perivarf/OpenRadioBuoy/hardware/buoy_PCB/OLB.kicad_pcb

## KiCad design hardware/buoy_PCB/OLB.kicad_pcb (2026-11-14)

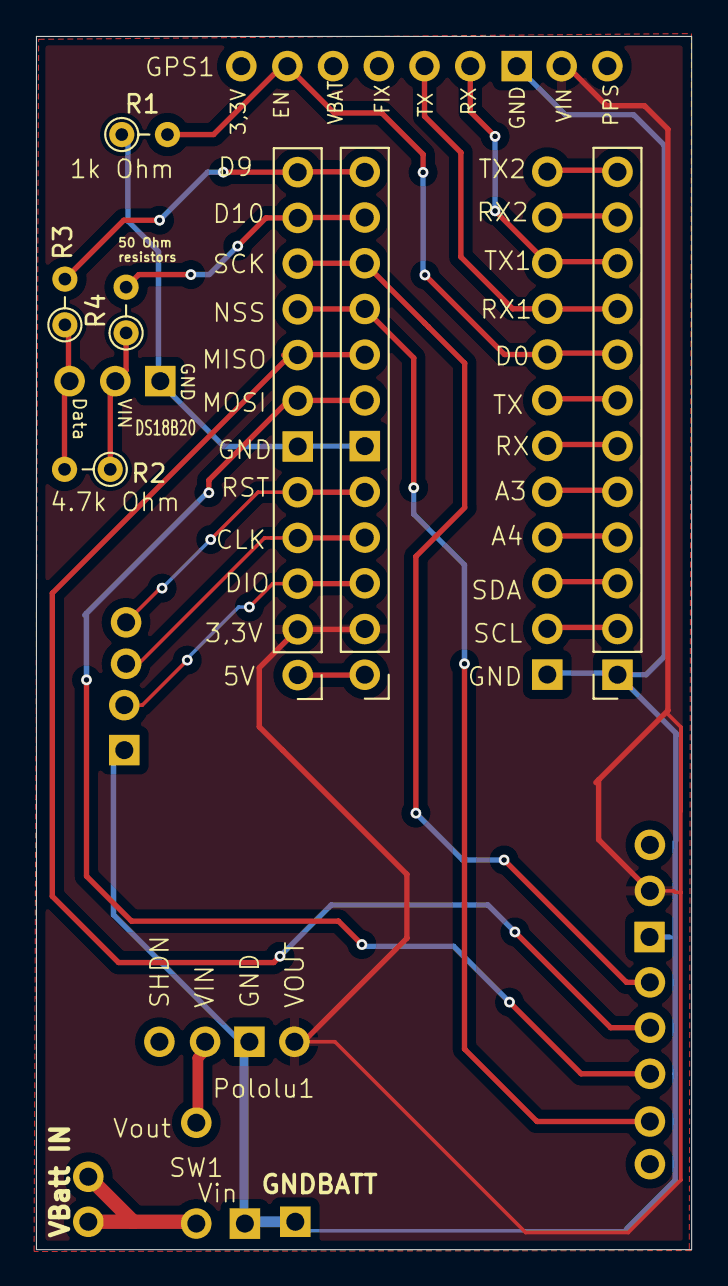
[picture p1: board OLB.kicad_pcb from above]

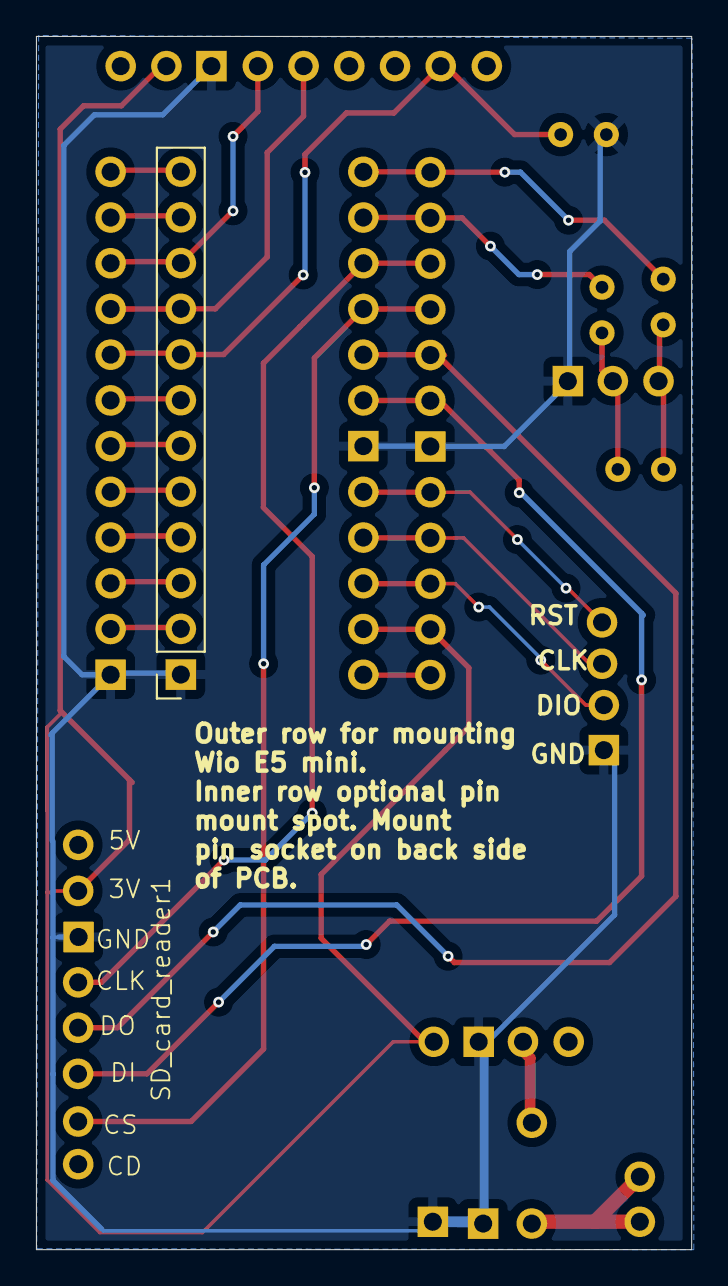
[picture p2: board OLB.kicad_pcb from below]

Board: 2 copper layers, 36.4 x 67.4 mm, 11 parts (2 on the bottom side), 14 nets.

Parts:
DS18B20: DS18B20
GPS1: GPS
Pololu1: Pololu3,3V
R1: 1k Ohm; R_Axial_DIN0204_L3.6mm_D1.6mm_P2.54mm_Vertical
R2: 4.7k Ohm; R_Axial_DIN0204_L3.6mm_D1.6mm_P2.54mm_Vertical
R3, R4: 50 Ohm; R_Axial_DIN0204_L3.6mm_D1.6mm_P2.54mm_Vertical
RHS Wio pins: PinSocket_1x12_P2.54mm_Vertical
SD_card_reader1: 254; SD_writer
SW1: SW_Reed; ReedSwitch
Wio1: WIO_E5_THT

Connections:
GND: DS18B20.Gn (GND), GPS1.Gn (GND), Pololu1.Gn (GND), R1.1, RHS Wio pins.1, SD_card_reader1.Gn (GND), Wio1.Gn (GND)
unnamed: DS18B20.TD (D), R2.2, R3.1
unnamed: DS18B20.TV (Vin), R2.1, R4.1
unnamed: GPS1.2G (EN), R1.2, RHS Wio pins.8, Wio1.D0
unnamed: GPS1.6G (RX), RHS Wio pins.10, Wio1.TX1
unnamed: GPS1.5G (TX), RHS Wio pins.9, Wio1.RX1
unnamed: GPS1.3V (VIN), Pololu1.3V (Vout), SD_card_reader1.3V, Wio1.3V (3,3V)
unnamed: Pololu1.Pin (Vin), SW1.1
unnamed: R3.2, Wio1.D9
unnamed: R4.2, Wio1.D10
unnamed: SD_card_reader1.SDCL (CLK), Wio1.A1 (SCK)
unnamed: SD_card_reader1.SDCS (CS), Wio1.NSS
unnamed: SD_card_reader1.SDDI (DI), Wio1.A5 (MOSI)
unnamed: SD_card_reader1.SDDO (DO), Wio1.A6 (MISO)
