perivarf/OpenRadioBuoy/firmware/drifter/src/main.cpp

#include <Arduino.h>
#include "config.h"
#include "etl_error_manager.h"
#include "messages.h"
#include "lora_transceiver.h"
#include "gps_manager.h"
#include "sd_writer.h"
#include "thermo_manager.h"
#include "IWatchdog.h"
#include "STM32LowPower.h"
#include "TimeLib.h"
/*
  TODO: 
  Get a good algorithm for getting a date stamp from GPS.
  This feature is currently disabled. 
*/

HardwareSerial mySerial{DEBUG_SERIAL_RX_PIN, DEBUG_SERIAL_TX_PIN};


/* Workaround for millis not increasing during sleep cycles */
uint32_t measurement_timer;
uint32_t beacon_timer = 0;
static uint32_t sleep_cycles_measurement  = 0;
static uint32_t sleep_cycles_transmission = 0;
static uint32_t sleep_cycles_beacon       = 0;
static uint32_t iterations_counter = 0;


uint32_t millis_time_corrected(uint32_t sleep_cycles){
  return millis() + sleep_cycles*sleep_time;
}

/*
  Jump to the system bootloader in ROM (0x1FFF0000 on STM32WLxx). After the
  jump the ROM bootloader listens on USART1 (PB6/PB7), the same pins as the
  serial console. Follows ST's official recipe: interrupts off, clocks back to
  reset state, NVIC cleared, MSP loaded from the bootloader vector table, then
  jump to its reset handler.
*/
static void jumpToBootloader(void){
  const uint32_t bootAddr = 0x1FFF0000UL;  // system memory, STM32WLE5 (AN2606)
  __disable_irq();
  SysTick->CTRL = 0;
  SysTick->LOAD = 0;
  SysTick->VAL  = 0;
  HAL_RCC_DeInit();
  for (uint8_t i = 0; i < 8; i++){  // disable and clear every NVIC interrupt
    NVIC->ICER[i] = 0xFFFFFFFFUL;
    NVIC->ICPR[i] = 0xFFFFFFFFUL;
  }
  __enable_irq();  // the bootloader needs interrupts for UART reception
  void (*bootJump)(void) = (void (*)(void))(*((uint32_t *)(bootAddr + 4)));
  __set_MSP(*(uint32_t *)bootAddr);
  bootJump();  // never returns
}

/*
  Startup menu: press 'b' in the serial monitor within bootloader_menu_window
  to jump to the UART bootloader and flash without an ST-Link. One dot per
  second shows the window is still open. Runs before the watchdog is started,
  so the wait cannot trigger a reset.
*/
static void bootloaderWindow(void){
  mySerial.print(F("Press 'b' within "));
  mySerial.print(bootloader_menu_window/s_2_ms);
  mySerial.println(F(" s for bootloader mode..."));
  uint32_t windowStart = millis();
  uint32_t lastDot = windowStart;
  while (millis() - windowStart < bootloader_menu_window){
    if (mySerial.available() && mySerial.read() == 'b'){
      mySerial.println(F("\nJumping to bootloader - ready for UART flashing"));
      mySerial.flush();
      delay(50);  // let the line drain before the UART is torn down
      jumpToBootloader();
    }
    if (millis() - lastDot >= s_2_ms){
      mySerial.print(F("."));
      lastDot = millis();
    }
  }
  mySerial.println();
}

void setup() {

  // Serial debugging can be turned on or off with the debug_serial flag.
  // The bootloader menu needs the console too, so it also brings Serial up.
  if (debug_serial || enable_bootloader_menu){
    mySerial.begin(serial_baud);
    delay(100);
  }
  if (debug_serial){
    mySerial.println("Serial initialized!");
    delay(100);
  }

  if (enable_bootloader_menu){
    bootloaderWindow();
  }

  // We try to enable rtc timing
  setSyncInterval(1);

  // Watchdog begin
  if (enable_watchdog){
    IWatchdog.begin(1000*watchdog_wait_time);
  }
  /*
    Note, watchdog has .isReset member which allows us to resume operations in case of 
    shutdown. Look into implementation of restore from SD/RAM
  */

  // Start SD
  bool SD_fail = sd_writer.begin();  
  int8_t status = sd_writer.startLogging("boot_info.txt");
  if (!SD_fail && debug_serial){
    mySerial.println("SD opened");
    mySerial.print("Status code: ");
    mySerial.println(status);
  }
  IWatchdog.reload();


  /*
    Buoy will not start without working radio.
  */
  LORA.beginRadio(LoRa_freq_receive, LoRa_bw, LoRa_sf, LoRa_cr, LoRa_power);
  LORA.getWiOID();
  if (LORA.state == RADIOLIB_ERR_NONE){
    sd_writer.logString("Radio functional");
  } else {
    sd_writer.logString("Radio failed to start. Freezing sensor.");
    while(1);
  }

  if (SD_fail){
    if (debug_serial){
      mySerial.println(F("SD card mount failed. Proceeding with Radio only"));
    }
    delay(100);
  }
  
  /*
    We monitor possible overflow in ETL storage containers
  */
  etl::error_handler::set_callback<etl_error_func>();

  sd_writer.logString("Beginning GPS");

  IWatchdog.reload();
  gps_manager.begin(GPS_baud);

  int8_t  nofix = 1;

  /*
    Buoy will not advance until it has gotten a fix
  */
  while (nofix){
    gps_manager.updateTimestamp(10*max_GPS_read_time, true);
    nofix = gps_manager.performNReadings(1,10*max_GPS_read_time, true);
    delay(100);
    IWatchdog.reload();
  }

  gps_manager.processReadings(false);

  /*
    We need to read the attached thermistors for a buoy ID
  */
  thermo_manager.begin(THERMO_DATA_PIN, THERMO_POWER_PIN);

  gps_manager.getDeploymentMessage(LORA.WiO_ID);
  LORA.startup_timestamp = gps_manager.timestamp;
  IWatchdog.reload();
  if (debug_serial){
    mySerial.println("Sending deployment message");
  }
  if (IWatchdog.isReset() == false && transmitDeploymentMessage){
    /*
      We wait until we get a fix from a base station before proceeding.
      Allows us to make sure the buoy works before tossing it into the water. 
    */
    while (!LORA.connectToBaseStation(max_radio_fix_look_time, max_radio_fix_look_time)) {
      IWatchdog.reload();
    }
    
    LORA.transmitB(gps_manager.deploymentMessage, deployment_message_size);
    sd_writer.logString(gps_manager.deploymentMessage, deployment_message_size);
    LORA.waitUntilReady();
  }
  
  LORA.lastTransmission = millis();
  if (IWatchdog.isReset() == true){
    //We check to see if the buoy crashed
    sd_writer.logString("Watchdog crashed during execution of loop. This is a reboot.");
  }


  measurement_timer = millis();
  if (enable_recovery_beacon){
    beacon_timer = millis();
  }
  /*
    Start low power management. As low power requires all connections 
    to be off, we turn them off here, before
    enabling them again in the loop. 
  */ 
  LowPower.begin();
  gps_manager.shutdownGPS();
  sd_writer.closeLog();
  thermo_manager.sleep();
  LORA.sleep();

  
  // We try to recover a GPS measurement:
  //char targetFile[64];
  //sprintf(targetFile, "readings/reading%05d.txt", 3);
  //sd_writer.startReading(targetFile);
  //sd_writer.readFile();
  //gps_manager.getMeasurementFromFile();
  //thermo_manager.getMeasurementFromFile();
  //sd_writer.closeRead();


  if (debug_serial){
    mySerial.println("Setup complete, loop beginning");
    delay(100);
    mySerial.end();
  }


}

void task_measure_gps_temp() {

  // Measure time!
  unsigned long measurement_start = millis();

  // Wake up sensors
  gps_manager.begin(GPS_baud);
  thermo_manager.wake();
  IWatchdog.reload();

  char logname[25];
  sprintf(logname, "readings/reading%05d.txt", sd_writer.logCount);
  
  if (!sd_writer.active){
    sd_writer.begin();
  }
  sd_writer.startLogging(logname);
  IWatchdog.reload();

  // We read each sensor
  if (debug_serial){
    mySerial.println("Reading sensors");
    mySerial.println(gps_manager.iterations);
    delay(100);
  }
  
  // success_gps_read is 0 if the buoy got a fix
  uint8_t success_gps_read = gps_manager.updateTimestamp(max_GPS_read_time, resync_RTC_using_GPS);
  if (success_gps_read == 0){
    gps_manager.performNReadings(readings_per_measurement,max_GPS_read_time, log_every_reading);
    gps_manager.processReadings(true);

    // We should turn off the GPS post reading due to power consumption
    gps_manager.shutdownGPS();

    thermo_manager.takeReadings(max_sensor_read_time, gps_manager.timestamp, log_every_reading);
    thermo_manager.processReadings();


    IWatchdog.reload();
    // We update the measurements period to reflect the new motion paradigme
    if (enable_motion_detection){
      LORA.updateMeasurementFrequency(gps_manager.current_buoy_velocity, maximal_measurement_period, minimal_measurement_period);
    }
  } else {
    // If no fix was found, we skip this measurement and hope for better luck the next time around. 
    gps_manager.shutdownGPS();
  }
  // Turning off remaining sensors
  sleep_cycles_measurement = 0;
  measurement_timer = millis_time_corrected(sleep_cycles_measurement);
  thermo_manager.sleep();
  sd_writer.closeLog();
  IWatchdog.reload();
}
  

void task_transmit() {

  if (debug_serial){
    mySerial.println("Looking for base station");
  }
  
  char logname[30];
  sprintf(logname, "messages/transmission%05d.txt", LORA.msgCounter);

  if (!sd_writer.active){
    sd_writer.begin();
  }

  sd_writer.startLogging(logname);
  IWatchdog.reload();
  LORA.wakeUp();
  sd_writer.logString("Looking for base station");

  // Handshake
  if (perform_handshake){
    if (LORA.connectToBaseStation(max_radio_fix_look_time, max_radio_wait_time)){
    sd_writer.logString("Hands shaked");
    } else {
    sd_writer.logString("No base station found");
    } 
    delay(send_delay_after_handshake);
  } else {
      // We do not check if a base station is present
      LORA.available = true;
      LORA.listenTime = 60*s_2_ms;
  }

  Message_Data message_data;
  sd_writer.logString("Transmitting data\n--------\n");

  // We dump as much information as possible to the base station
  // In the time period alloted to us
  while (LORA.available && (thermo_manager.temperatures.size() > 0)){

    // GPS data
    if (debug_serial){
        mySerial.print("Sending G: "); mySerial.print(GPS_message_size); mySerial.println(" bytes");
    }
    
    gps_manager.updateTransmitMessage();
    message_data = LORA.sendData(gps_manager.msgB, GPS_message_size, 10000);
    delay(500);

    sd_writer.logByteArray(gps_manager.msgB, GPS_message_size);
    sd_writer.logSignalInfo(message_data.RSSI, message_data.SNR);

    // Thermometer data
    if (debug_serial){ mySerial.print("Sending T: "); mySerial.print(thermo_message_size); mySerial.println(" bytes");}

    thermo_manager.updateTransmitMessage();
    message_data = LORA.sendData(thermo_manager.msgB, thermo_message_size, 10000);
    IWatchdog.reload();

    delay(500);
    sd_writer.logByteArray(thermo_manager.msgB, thermo_message_size);
    sd_writer.logSignalInfo(message_data.RSSI, message_data.SNR);

    delay(200);
    LORA.packet_count++;
    IWatchdog.reload();

    if (debug_serial){
      mySerial.print("Available: ");
      mySerial.println(LORA.available);
      mySerial.print("Num packets left: ");
      mySerial.println(thermo_manager.temperatures.size());
    }

    delay(500);
  }
  
  // Wrap up transmission, wait for base station instructions
  if (LORA.available){
    LORA.transmitFinished(thermo_manager.temperatures.size());
    if (enable_baseStation_parameter_updates){
      // We listen for new parameters
      LORA.receiveInstructions();

      // Then we listen for which measurements to add back to memory from 
      // SD card - TBD
      //LORA.receiveDesiredMeasrements();
      //sd_writer.fetchRequestedMeasurements(LORA.measurementTargets);
    }
    LORA.updateMeasurementFrequency(gps_manager.current_buoy_velocity, maximal_measurement_period, minimal_measurement_period);

  }
  
  sd_writer.logString("Transmission done");
  sd_writer.closeLog();

  sleep_cycles_transmission = 0;
  measurement_timer = millis();
  LORA.lastTransmission = millis();
  LORA.sleep();

}

void task_beacon(){
    LORA.wakeUp();
    gps_manager.updateBeaconMsg(LORA.WiO_ID);
    LORA.transmitBeaconMessage(gps_manager.beaconMsg, beaconMsgSize);
    sleep_cycles_beacon = 0;
    beacon_timer        = millis();
    LORA.sleep();
}

void loop() {
  /*
    We start by checking if we should switch on each sensor
  */
  IWatchdog.reload();
  bool disable_sensors = false;

  if (debug_serial){
    mySerial.begin(serial_baud);
    delay(100);
    mySerial.println("Booting up!");

  }

  // Measurement loop (temperature and GPS)
  if (millis_time_corrected(sleep_cycles_measurement) - measurement_timer > LORA.measurement_period){
      task_measure_gps_temp();
  }
  
  // Transmission protocol
  if ((millis_time_corrected(sleep_cycles_transmission) - LORA.lastTransmission > minimal_transmission_period) && 
      (gps_manager.GPSReadings.size() > packet_count_send_treshold)) {  
        task_transmit();
  }

  // Recovery protocol
  if ((millis_time_corrected(sleep_cycles_beacon) - beacon_timer > beacon_ping_period) && (enable_recovery_beacon)){
    task_beacon();
  }

  if (debug_serial){
    mySerial.println("\n Succesfull iteration, starting to log\n");
    mySerial.println("Logging finished");
    mySerial.println(F("Shutting down"));
    delay(100);
    mySerial.end();
  }
  
  // We sleep for "sleep_time" before waking up to refresh the watchdog
  IWatchdog.reload();
  sleep_cycles_measurement++;
  sleep_cycles_transmission++;
  if (sd_writer.active){
    sd_writer.shutdown();
  }
  delay(150);
  LowPower.sleep(sleep_time);
}
