perivarf/OpenRadioBuoy/firmware/common_libraries/wave_manager/src/wave_message.cpp

#include "wave_manager.h"

#include <math.h>
#include <TimeLib.h>
#include "parser_utils.h"

/*
  Serialising a result for the radio, and the DEBUG_WAVE_MSG test that
  exercises the same path without a capture.
*/

// -----------------------------------------------------------------------------
// Serialise the front result. A measurement goes out as two messages: 
// 1) the parameters in msgB ('W' ... 'E') and 
// 2) the spectrum in psdB ('P' ... 'E'), paired by ts_start
// -----------------------------------------------------------------------------

// Physical value -> the uint32 fixed point the wave parameters travel in.
static uint32_t waveToFixed(float v) {
  if (!(v > 0.0f)) return 0;                       // undefined (-1) or negative -> 0
  double scaled = (double)v * (double)scale_factor;
  if (scaled > 4294967295.0) return 0xFFFFFFFFUL;  // clamp to uint32 range
  return (uint32_t)llround(scaled);
}

size_t WaveManager::updateTransmitMessage(void) {
  if (wave_analysis_results.empty()) return 0;
  WaveResult res = wave_analysis_results.front();

  uint8_t offset = 0;
  msgB[offset++] = 'W';
  msg_insert_uint(msgB, res.reading_ID, offset, wave_message_size, offset, true);

  // Full time_t, 8 bytes, as every other message here serialises it. See readings.h.
  msg_insert_uint(msgB, res.timestamp_start, offset, wave_message_size, offset, true);
  msg_insert_uint(msgB, res.timestamp_end,   offset, wave_message_size, offset, true);

  msg_insert_uint(msgB, waveToFixed(res.Hs), offset, wave_message_size, offset, true);
  msg_insert_uint(msgB, waveToFixed(res.Tc), offset, wave_message_size, offset, true);
  msg_insert_uint(msgB, waveToFixed(res.Tp), offset, wave_message_size, offset, true);
  msg_insert_uint(msgB, waveToFixed(res.Tz), offset, wave_message_size, offset, true);

  // msg_insert_int so the sign survives: sign-and-magnitude, five bytes each, the same
  // encoding the 'G' message uses. Already 1e-7 deg (gps_coord_scale)
  msg_insert_int(msgB, res.lat_start_e7, offset, wave_message_size, offset, true);
  msg_insert_int(msgB, res.lng_start_e7, offset, wave_message_size, offset, true);
  msg_insert_int(msgB, res.lat_end_e7,   offset, wave_message_size, offset, true);
  msg_insert_int(msgB, res.lng_end_e7,   offset, wave_message_size, offset, true);

  msgB[offset++] = 'E';

  /*
    The result is deliberately not popped here. The caller pops with
    popTransmittedResult() once the radio has confirmed TxDone. 
    A failure leaves the result at the head of the queue for the next window.
  */
  return offset;
}

size_t WaveManager::updatePsdTransmitMessage(void) {
  
  // Return if empty queue
  if (wave_analysis_results.empty() || !kSendPsd) return 0;

  WaveResult res = wave_analysis_results.front();

  uint8_t offset = 0;
  psdB[offset++] = 'P';
  msg_insert_uint(psdB, res.reading_ID, offset, wave_spectrum_message_size, offset, true);

  // The join key. Must be byte-identical to the value the 'W' message carried
  msg_insert_uint(psdB, res.timestamp_start, offset, wave_spectrum_message_size, offset, true);

  // max_value gets wave_psd_scale, not scale_factor. An acceleration PSD is orders of
  // magnitude smaller than a wave height or a period, and at 1e5 a calm-sea peak rounds
  // to 0 - which zeroes the whole spectrum on the far side, since every bin is
  // reconstructed as (value/65535)^2 * max_value. See readings.h for the range.
  auto toPsdFixed = [](float v) -> uint32_t {
    if (!(v > 0.0f)) return 0;                       // undefined (-1) or negative -> 0
    double scaled = (double)v * (double)wave_psd_scale;
    if (scaled > 4294967295.0) return 0xFFFFFFFFUL;  // clamp to uint32 range
    return (uint32_t)llround(scaled);
  };

  msg_insert_uint(psdB, toPsdFixed(res.max_value), offset, wave_spectrum_message_size, offset, true);
  
  auto toFreqFixed = [](float f) -> uint32_t {
    return (uint32_t)llround((double)f * (double)wave_freq_scale);
  };

  // Frequency axis, so the base station can label the bins: bin centers
  msg_insert_uint(psdB, toFreqFixed(kSpecFMinHz), offset, wave_spectrum_message_size, offset, true);
  msg_insert_uint(psdB, toFreqFixed(kSpecFMaxHz), offset, wave_spectrum_message_size, offset, true);
  msg_insert_uint(psdB, (uint16_t)kSpecTxBins,    offset, wave_spectrum_message_size, offset, true);

  // Wave spectrum is the last field. It is variable length, so that we can send as short
  // messages as possible over the wire
  // kSpecTxBins is at most welch_bins - the capacity of wave_spectrum_message_size, and
  // is smaller whenever kPsdMaxFreq does not divide evenly into the bin grid.
  for (size_t i = 0; i < kSpecTxBins; i++) {
    msg_insert_uint(psdB, res.wave_spectrum[i], offset, wave_spectrum_message_size, offset, true);
  }
  psdB[offset++] = 'E';
  return offset;
}

void WaveManager::popTransmittedResult(void) {
  if (!wave_analysis_results.empty()) wave_analysis_results.pop_front();
}

#if DEBUG_WAVE_MSG
// Synthetic result for bench testing - see DEBUG_WAVE_MSG in wave_config.h.
void WaveManager::enqueueFakeResult(void) {
  WaveResult res{};
  res.reading_ID = ++readingID_;

  // Synthetic result for bench testing - see DEBUG_WAVE_MSG in wave_config.h.
  res.Hs        = 1.37f;   // m
  res.Tc        = 2.53f;   // s
  res.Tp        = 6.91f;   // s
  res.Tz        = 4.29f;   // s
  res.max_value = 0.0842f; // peak acceleration PSD ((m/s^2)^2/Hz)

  // A single smooth peak, sqrt(binAcc/peakAcc) * 65535
  // so the receiving side reconstructs (value/65535)^2 * max_value
  const float peakBin = 0.35f * (float)kSpecNBins;
  const float width   = 0.12f * (float)kSpecNBins;
  for (size_t j = 0; j < kSpecNBins; j++) {
    const float d = ((float)j - peakBin) / width;
    const float norm = expf(-0.5f * d * d);
    res.wave_spectrum[j] = (uint16_t)lroundf(sqrtf(norm) * 65535.0f);
  }

  res.timestamp_end   = now();
  res.timestamp_start = res.timestamp_end -
                        (time_t)(wave_capture_duration / s_2_ms);

  // A short synthetic drift with both signs present: a receiver that drops the sign
  // character, or reads the pair in the wrong order, cannot produce these four numbers
  // by accident
  res.lat_start_e7 =  599578000;   //  59.9578 N
  res.lng_start_e7 =  110686000;   //  11.0686 E
  res.lat_end_e7   =  599601000;   //  59.9601 N, drifted north
  res.lng_end_e7   =  -110701000;  // -11.0701, i.e. W: exercises the sign byte

  // Same bound handling as processCapture: the deque is fixed-size, and dropping the
  // oldest keeps the freshest results when transmit cannot keep up.
  if (wave_analysis_results.full()) wave_analysis_results.pop_back();
  wave_analysis_results.push_front(res);
}

// What is about to go on the air, in physical units - so a scaling or field-order
// mistake in updateTransmitMessage is visible against these numbers rather than only
// after decoding on the base station.
void WaveManager::printPendingResult(Print &out) const {
  if (wave_analysis_results.empty()) return;
  const WaveResult &r = wave_analysis_results.front();

  out.print(F("  wave result #"));  out.println(r.reading_ID);
  out.print(F("    Hs "));  out.print(r.Hs, 3);  out.print(F(" m   Tc "));
  out.print(r.Tc, 3);       out.print(F(" s   Tp "));
  out.print(r.Tp, 3);       out.print(F(" s   Tz "));
  out.print(r.Tz, 3);       out.println(F(" s"));
  out.print(F("    max_value "));  out.print(r.max_value, 9);
  out.print(F(" (m/s^2)^2/Hz   span "));
  out.print((uint32_t)(r.timestamp_end - r.timestamp_start));  out.println(F(" s"));

  char ts[64];
  sprintf(ts, "    window %lu .. %lu",
          (unsigned long)r.timestamp_start, (unsigned long)r.timestamp_end);
  out.println(ts);

  // Position at each end of the window, printed as the receiver will read it:
  // 1e-7 deg back to degrees. 0,0 is what a window without a fix sends
  auto printPos = [&out](const __FlashStringHelper *label, int32_t lat, int32_t lng) {
    out.print(label);
    if (lat == 0 && lng == 0) { out.println(F(" no fix (0,0)")); return; }
    out.print(' ');  out.print((double)lat / gps_coord_scale, 6);
    out.print(F(", ")); out.println((double)lng / gps_coord_scale, 6);
  };
  printPos(F("    pos start"), r.lat_start_e7, r.lng_start_e7);
  printPos(F("    pos end  "), r.lat_end_e7,   r.lng_end_e7);

  // Raw uint16 and decoded value side by side, so the payload can be checked without
  // doing (value/65535)^2 * max_value by hand
  //
  // The frequency is built from kSpecFMinHz and kSpecBinWidthHz
  if (!kSendPsd) {
    out.println(F("    PSD not transmitted (kSendPsd off) - num_bins 0"));
    return;
  }

  out.print(F("    PSD, "));      out.print((uint32_t)kSpecTxBins);
  out.print(F(" bins, f_min "));  out.print(kSpecFMinHz, 4);
  out.print(F(" Hz, f_max "));    out.print(kSpecFMaxHz, 4);
  out.print(F(" Hz, df "));       out.print(kSpecBinWidthHz, 6);
  out.println(F(" Hz (f_hz raw psd_acc):"));
  for (size_t j = 0; j < kSpecTxBins; j++) {
    out.print(F("      "));      out.print(kSpecFMinHz + j * kSpecBinWidthHz, 4);
    out.print(' ');              out.print(r.wave_spectrum[j]);
    out.print(' ');
    const float n = r.wave_spectrum[j] / 65535.0f;
    out.println(n * n * r.max_value, 9);
  }
}
#endif  // DEBUG_WAVE_MSG
