perivarf/OpenRadioBuoy/(commit log)

2026-07-22 First attempt with new ORB pcb. GNSS changed from uart to I2C. Led removed. Changed pins for radio.
2026-07-23 Merged platformio-files for basestation and drifter
    [main.cpp]
2026-11-14 ORB v2: GPS, wave measurement from IMU
    Squash of fix_imu_interrupt.
    Firmware for the ORB v2 PCB with IMU-based wave measurement, developed
    for the master's thesis "Integration of IMU Wave Measurements into Open
    Radio Buoy Platform" (UiO, 2026). Tested in three field experiments
    (Skjærhalden 2026-07-31, Katten 2026-08-30, Skjærhaldfjord 2026-08-31)
    and in stationary tests of power consumption and execution time. The
    full chain, from raw IMU samples on the buoy to sea state parameters
    sent to the base station, was demonstrated in situ.
    ORB v2 board, GPS (SAM-M8Q, UBX protocol over I2C)
    - Changed from NMEA over UART (TinyGPSPlus) to UBX over I2C.
    - Faster I2C.
    - NMEA off, periodic NAV-PVT i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
